ecarlos03/Senior_Project/Team Straw Hats 2nd Poster (1).png

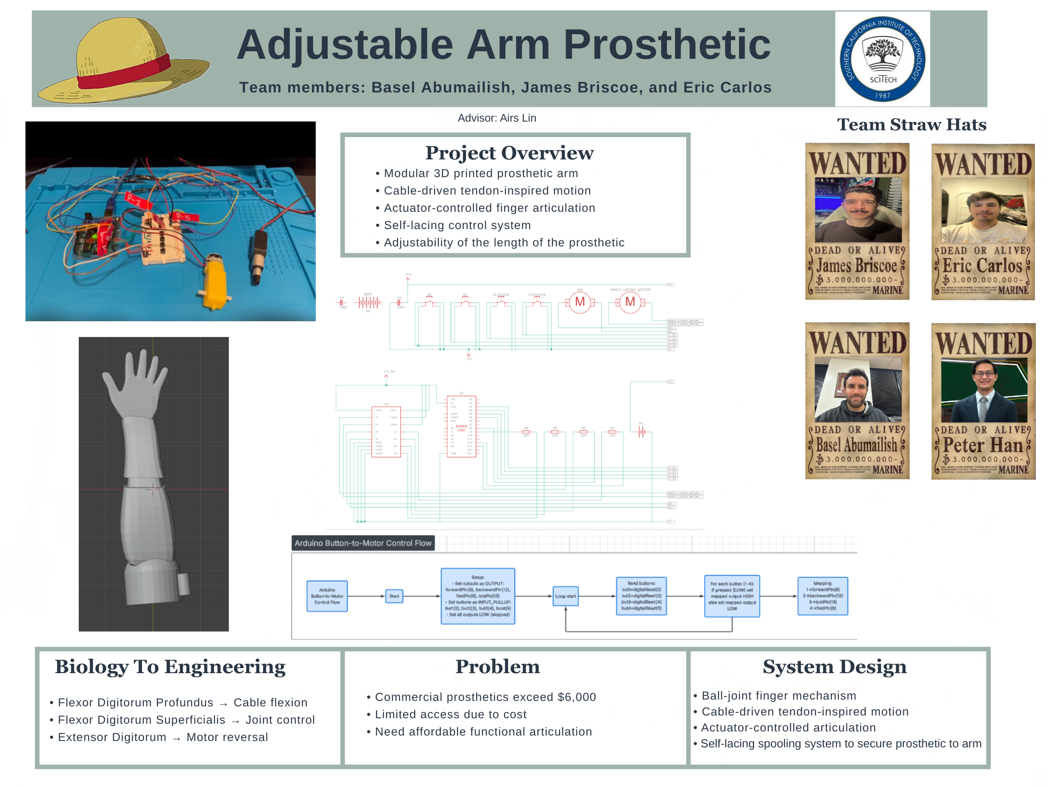
Team Straw Hats 2nd Poster (1).png
