ecarlos03/Senior_Project/Team Straw Hats Poster.png

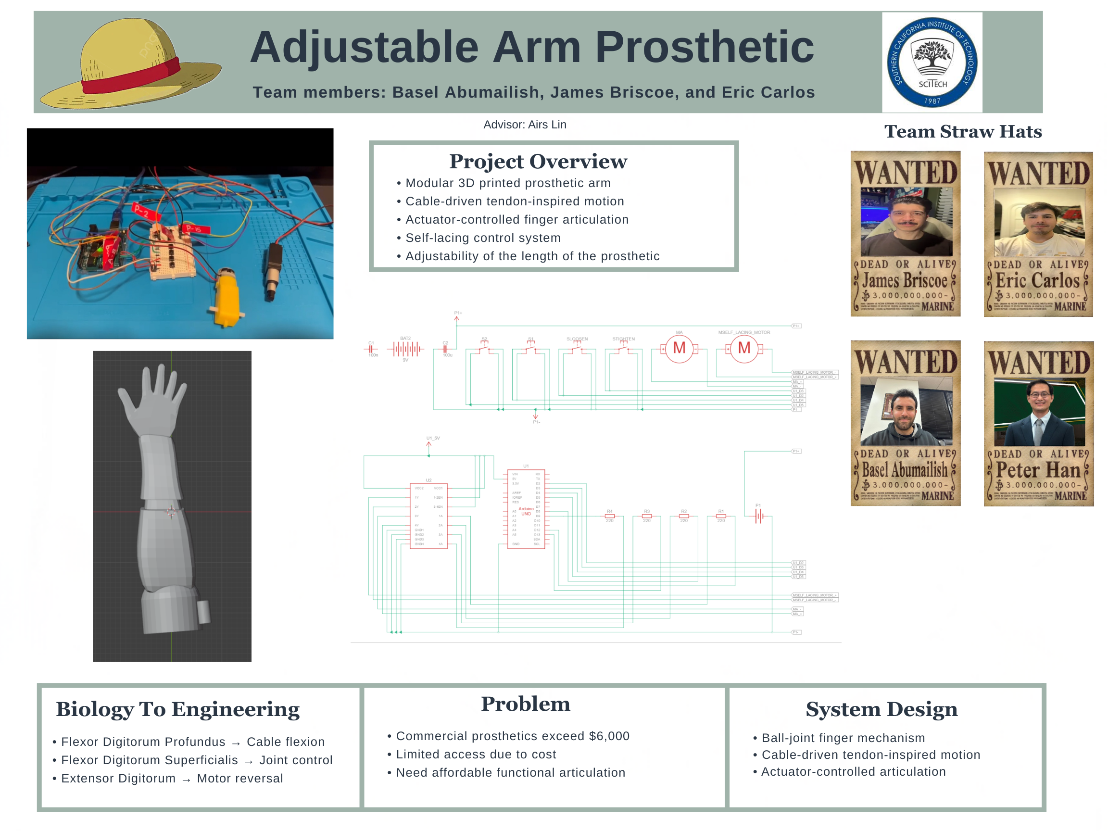
Team Straw Hats Poster.png
