ecarlos03/Senior_Project/Technical Meeting Minutes Week 4 (1).docx

Technical Meeting Minutes

Adjustable Arm Prosthetic

# Meeting Details

Date | 2026-02-01 | Time | 5:00 PM to 6:00 PM
Location | Zoom Meeting | Facilitator | Basel Abumailish
Recorder | Basel Abumailish | Meeting Type | Advisor Design Review
Attendees | Basel Abumailish, James Briscoe, Eric Carlos, Airs Lin | Optional | N/A
Pre-reads | Previous Weekly Meeting Minutes, Milestone Report 1 | Recording | N/A
Related Tickets | N/A | Repository | https://github.com/ecarlos03/Senior_Project

# Purpose / Objectives

• Introduce the project scope and overall system design to the advisor

• Clearly define team member roles and responsibilities

• Review current mechanical and electrical design direction at a high level

• Share current coding progress and receive initial feedback

# Agenda

Project overview and introduction.

Team roles and responsibilities.

Mechanical design overview, including joints and palm direction.

Coding and actuator progress overview.

Gantt Chart and Development Progress Review

(Discuss your progress with Gantt’s Chart.)

# GitHub Link Share and Updates

https://github.com/ecarlos03/Senior_Project

# Links / Artifacts

• Blender models showing completed finger joint geometry

• Early palm design drafts

• Circuit diagrams and coding files shared with the advisor

# Key Updates / Context

The team provided a high-level walkthrough of the Adjustable Arm Prosthetic design. Completed finger joints were presented as a major milestone. Ongoing work includes palm modeling, bracket development for actuator support, and continued coding and actuator testing. The advisor requested a clear introduction of the system and confirmation of each team member’s role. Discussed with Mr.Lin about circuit diagrams and coding problems that we are having trouble with. MR.Lin send over feedback on circuit diagram and ensured coding is fine just getting final progress done for schematics.

# Discussion Notes

Project Overview
• We provided an overview of the Adjustable Arm Prosthetic concept and system goals
• The design focus on adjustability, usability, and mechanical reliability was discussed

Team Roles
• Basel is responsible for bracket design, biomaterials considerations, and overall coordination
• James is responsible for palm modeling, hand geometry, and mechanical structure
• Eric is responsible for coding, actuator control, and electronics integration

Design Review
• Advisor reviewed the general mechanical and electrical approach
• No major design concerns were raised at this stage
• Emphasis was placed on maintaining clear documentation and role ownership

Coding and Electronics
• Current actuator control and coding progress was shared
• Advisor acknowledged progress and did not request immediate changes

Decisions

ID | Decision | Owner | Rationale / Notes
D-1 | Maintain current role distribution and parallel development approach | Team | Roles are clearly defined and support steady progress across mechanical and electrical tasks

# Action Items

ID | Action | Owner | Due | Priority | Status | Notes / Link
A-1 | Continue palm modeling using the completed finger joint geometry | James | 2026-02-08 | P1 | In Progress | [Ticket / Doc link]
A-2 | Continue bracket design for actuator mounting and alignment | Basel | 2026-02-08 | P1 | In Progress
A-3 | Continue coding, actuator testing, and maintain documentation for advisor review | Eric | 2026-02-11 | P1 | In Progress

# Risks / Blockers

• Integration complexity between the palm, joints, and bracket

– Impact. Medium

– Mitigation. Incremental integration and regular design checks

# Test Result

Joints were able to bend properly like natural fingers

# Open Questions

• Are there any documentation or formatting preferences the advisor would like followed for future updates

– Owner. Basel

– Target Date. 2026-02-07

Next Meeting

Date/Time: 2026-02-07, Time 5-6pm

Proposed agenda:

• Review palm design progress

• Review bracket integration status

• Update advisor on coding and actuator progress

Pre-work:

• Updated Blender models

• Updated coding files and diagrams
