ecarlos03/Senior_Project/arm.jpg

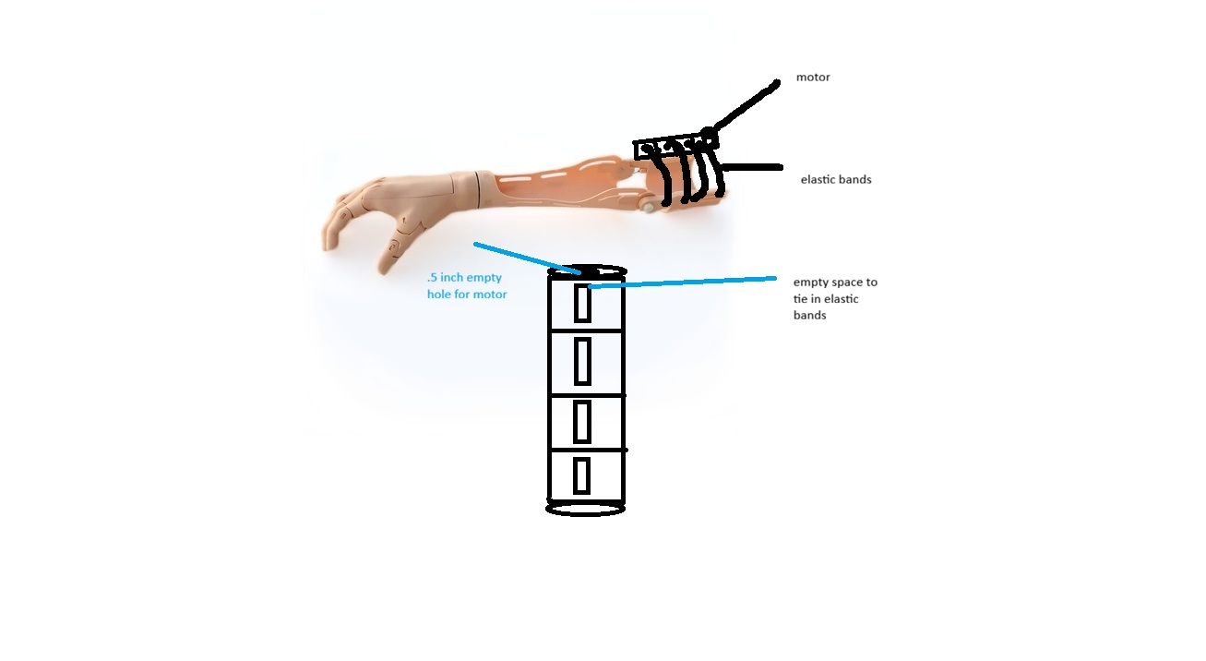
arm.jpg
