ecarlos03/Senior_Project/housing2.jpg

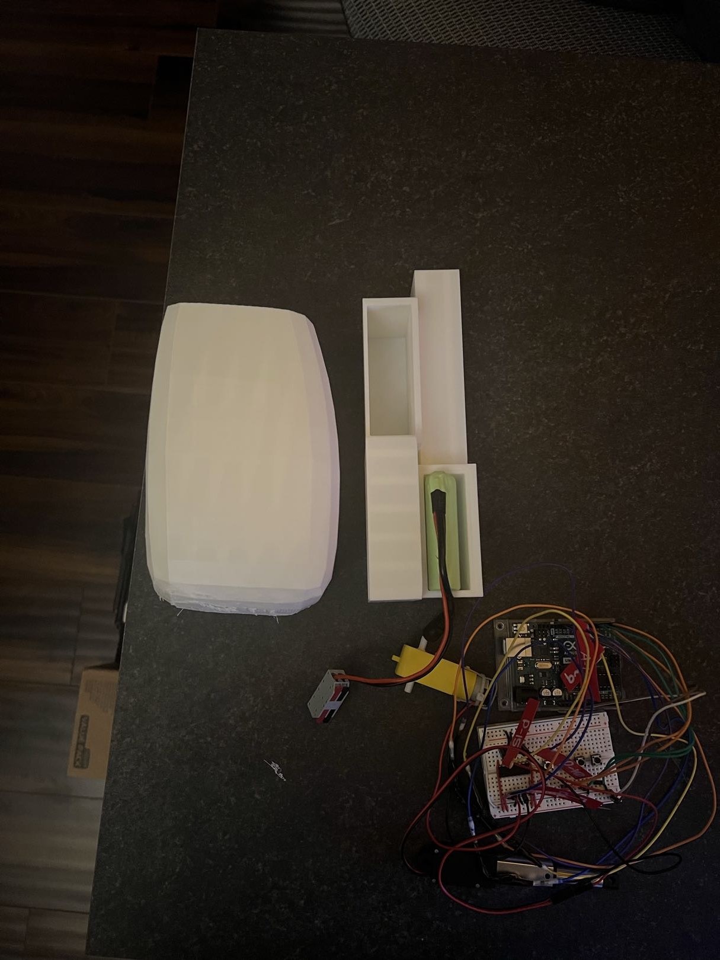
housing2.jpg
