ecarlos03/Senior_Project/housing3.jpg

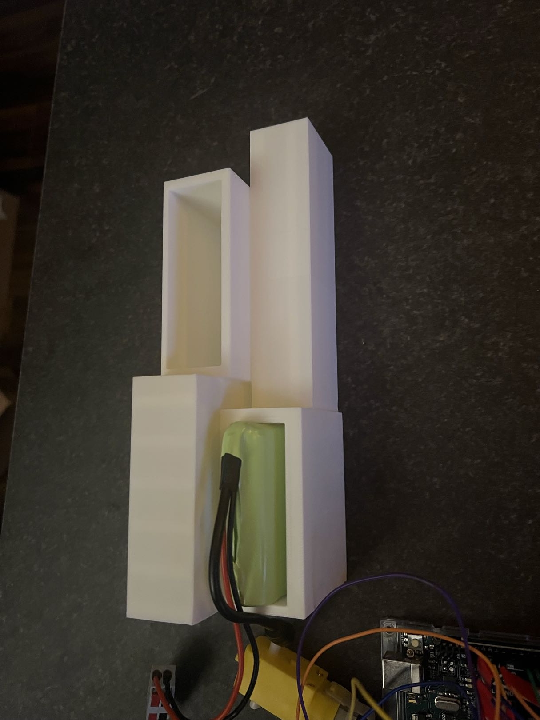
housing3.jpg
