ecarlos03/Senior_Project/housing4.jpg

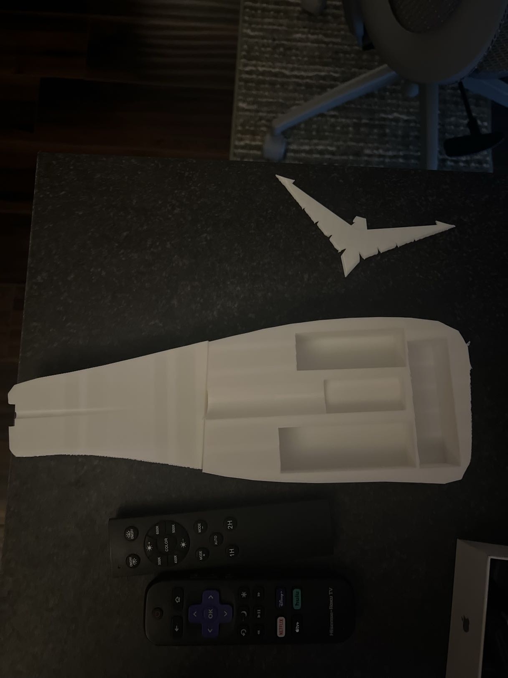
housing4.jpg
