ecarlos03/Senior_Project/housing.jpg

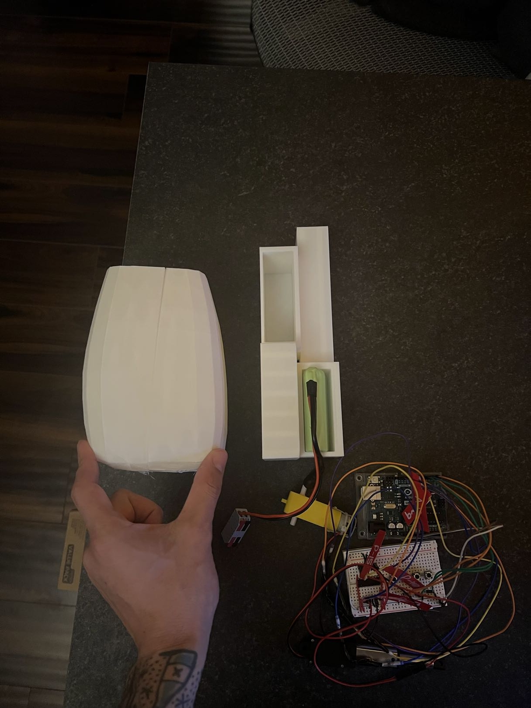
housing.jpg
