ecarlos03/Senior_Project/Screenshot 2026-01-31 171256.png

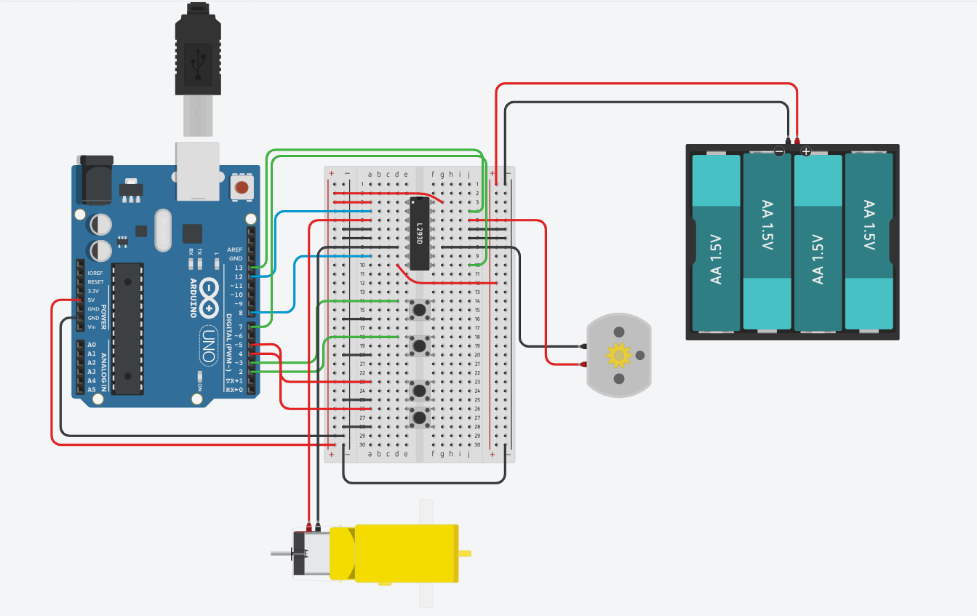
Screenshot 2026-01-31 171256.png
