ecarlos03/Senior_Project/Self-lacingmotorw_actuatorV3.pdf

A

1 | 2 | 3 | 4 | 5 | 6

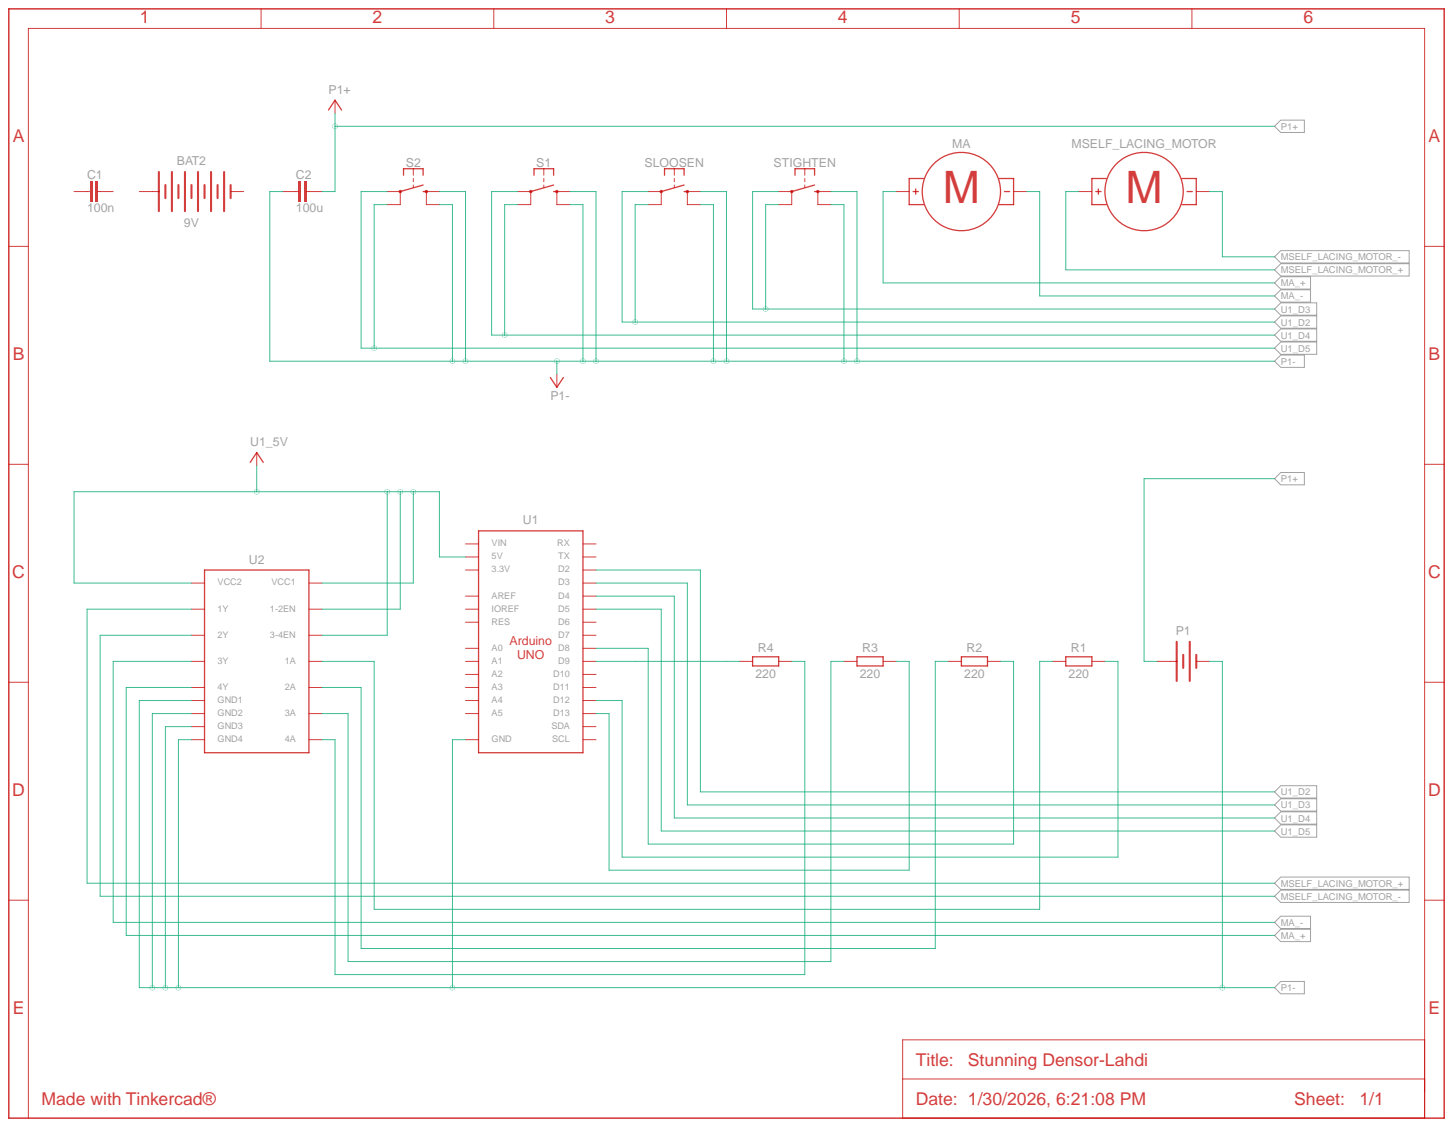
[picture p90: page 1]

Title: Stunning Densor-Lahdi
