ecarlos03/Senior_Project/Self-lacing motor w_actuatorV2.pdf

A

1 | 2 | 3 | 4 | 5 | 6

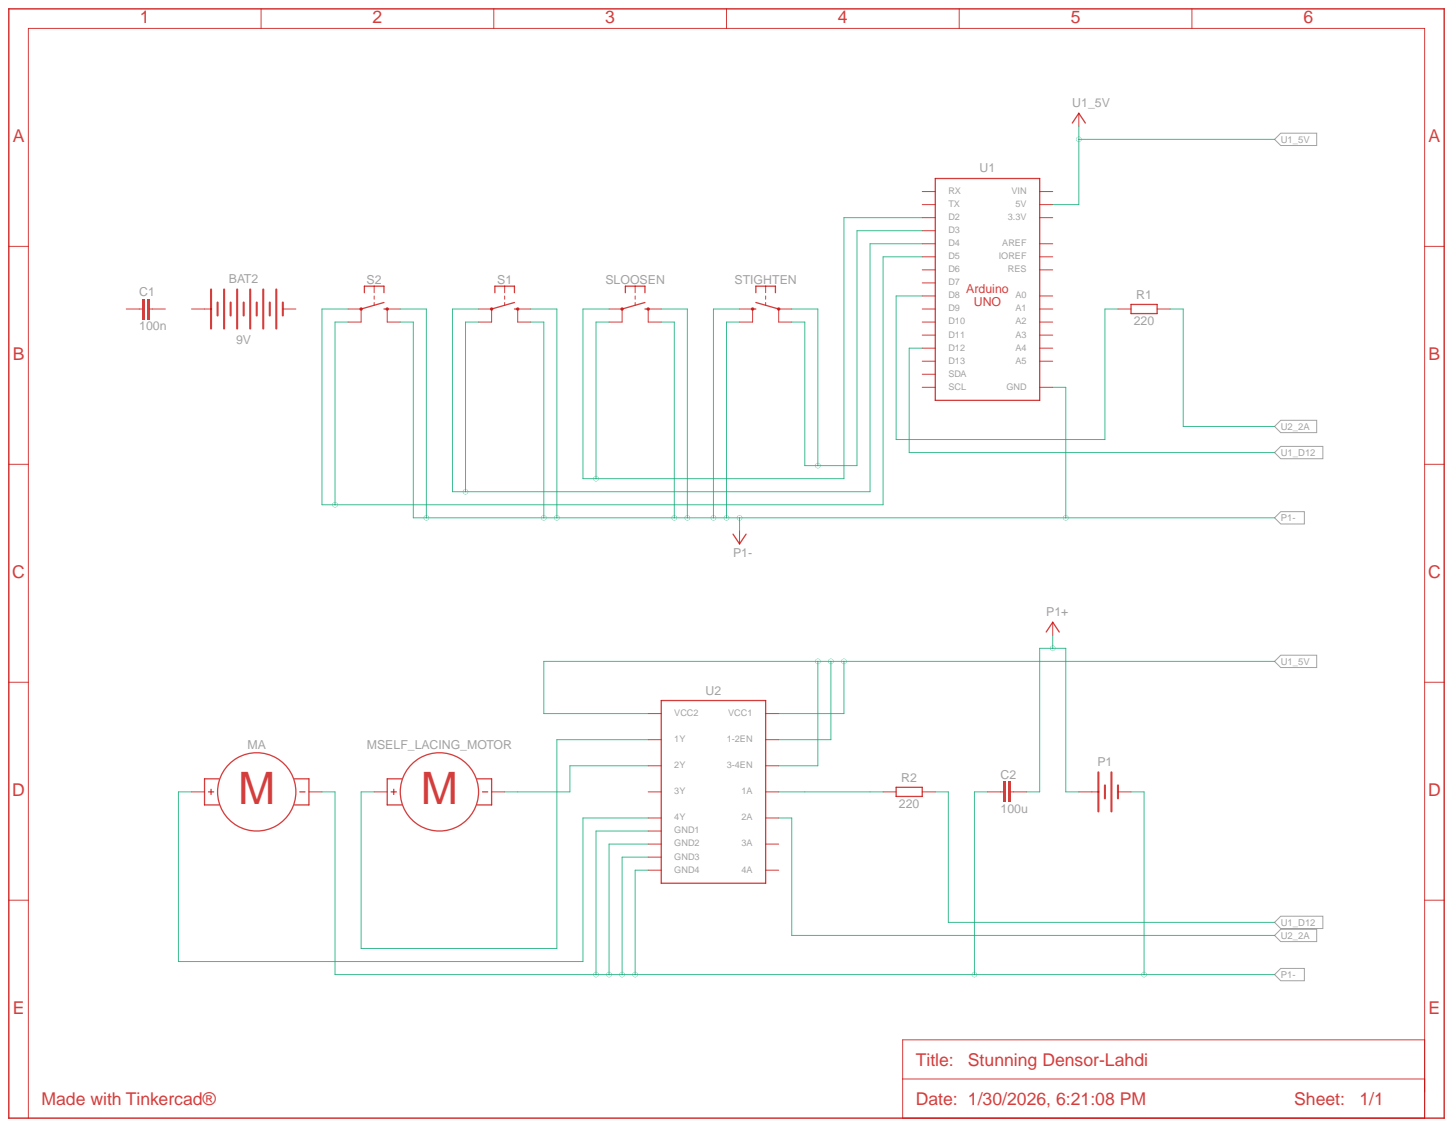
[picture p91: page 1]

Title: Stunning Densor-Lahdi
