ecarlos03/Senior_Project/Self-lacing motor w_actuator.pdf

A

1 | 2 | 3 | 4 | 5 | 6

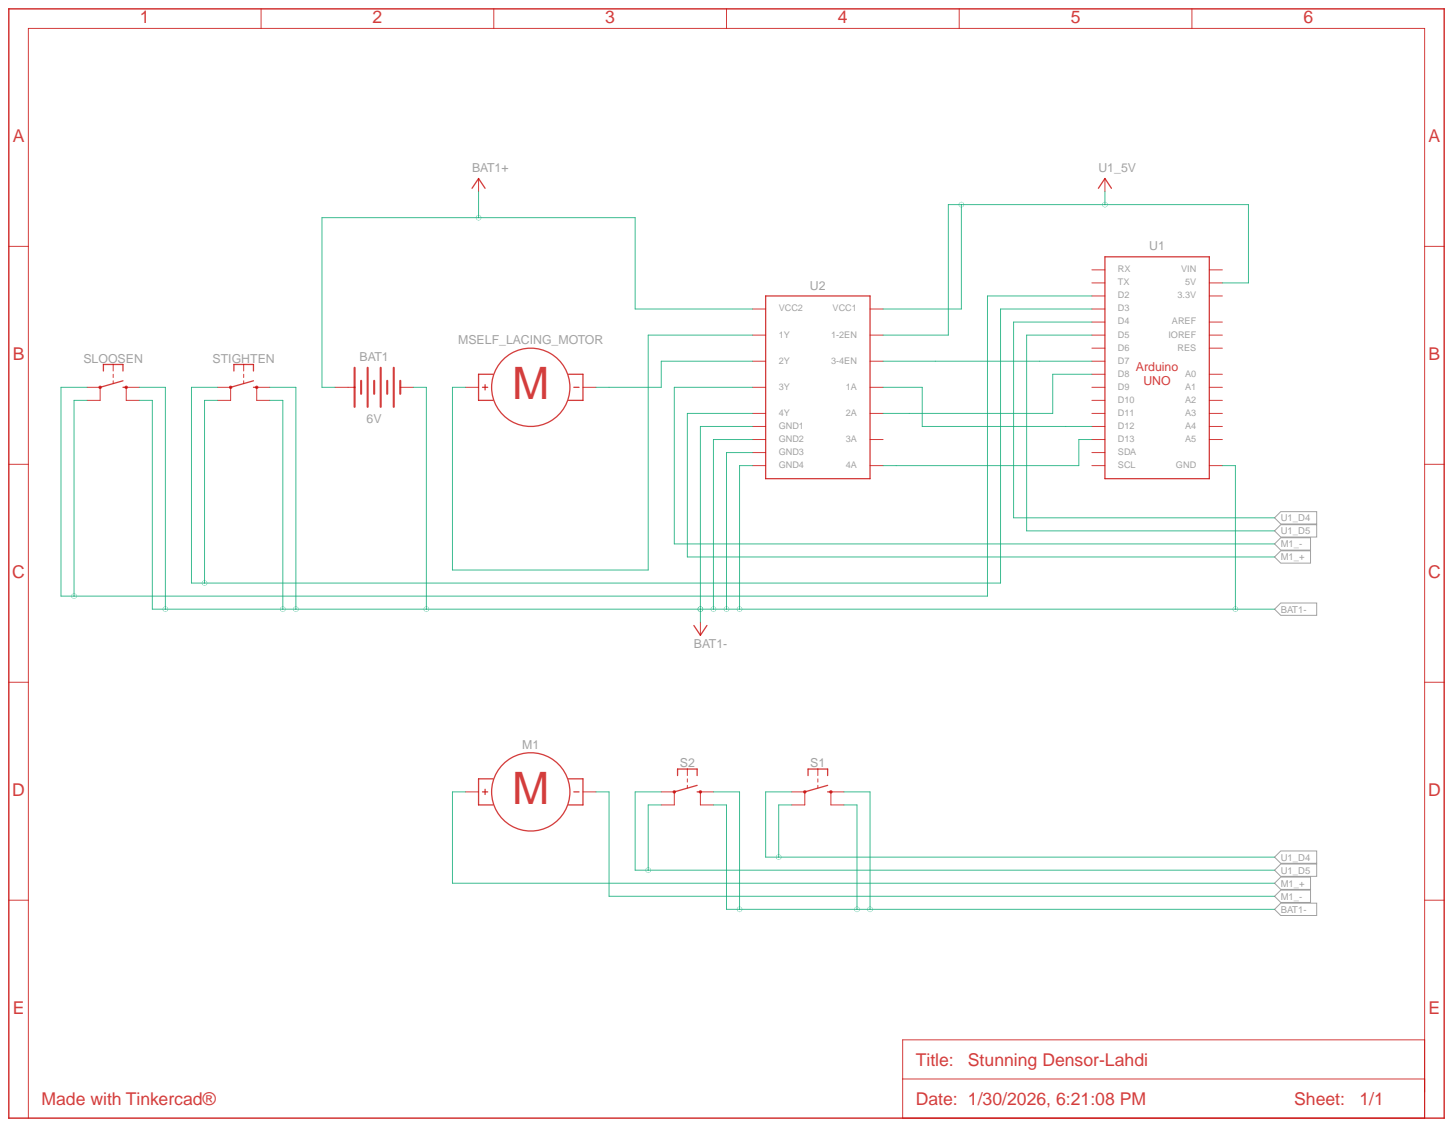
[picture p92: page 1]

Title: Stunning Densor-Lahdi
