ecarlos03/Senior_Project/self_lacing_motor_w_actuator1.ino

// declare variables
const int forwardPin = 8;
const int backwardPin = 12;
const int delayTime = 1000;
const int but1pin = 2;
const int but2pin = 3;
int but1;
int but2;

void setup() {
  pinMode(forwardPin, OUTPUT);
  pinMode(backwardPin, OUTPUT);
  pinMode(but1pin, INPUT_PULLUP);
  pinMode(but2pin, INPUT_PULLUP);
}

void loop() {
  but1 = digitalRead(but1pin);
  but2 = digitalRead(but2pin);

  if (but1 == HIGH) {
    digitalWrite(forwardPin, LOW);
  }
  else {
    digitalWrite(forwardPin, HIGH);
  }

  if (but2 == HIGH) {
    digitalWrite(backwardPin, LOW);
  }
  else {
    digitalWrite(backwardPin, HIGH);
  }
}
